thanhtung2105/Chika-CA-SWWx/Develop - Module CA-SWW/Schematic/87289124_199041944805929_6809010245046632448_n.png

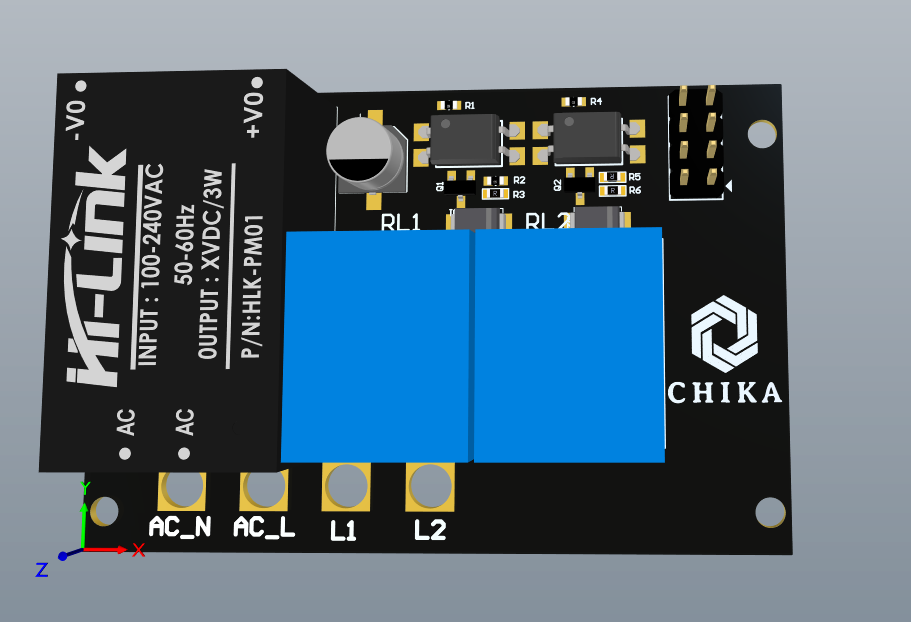
Develop - Module CA-SWW/Schematic/87289124_199041944805929_6809010245046632448_n.png
