thanhtung2105/Chika-CA-SWWx/Photos and Videos/89352153_235181460849834_5174523718583451648_n.jpg

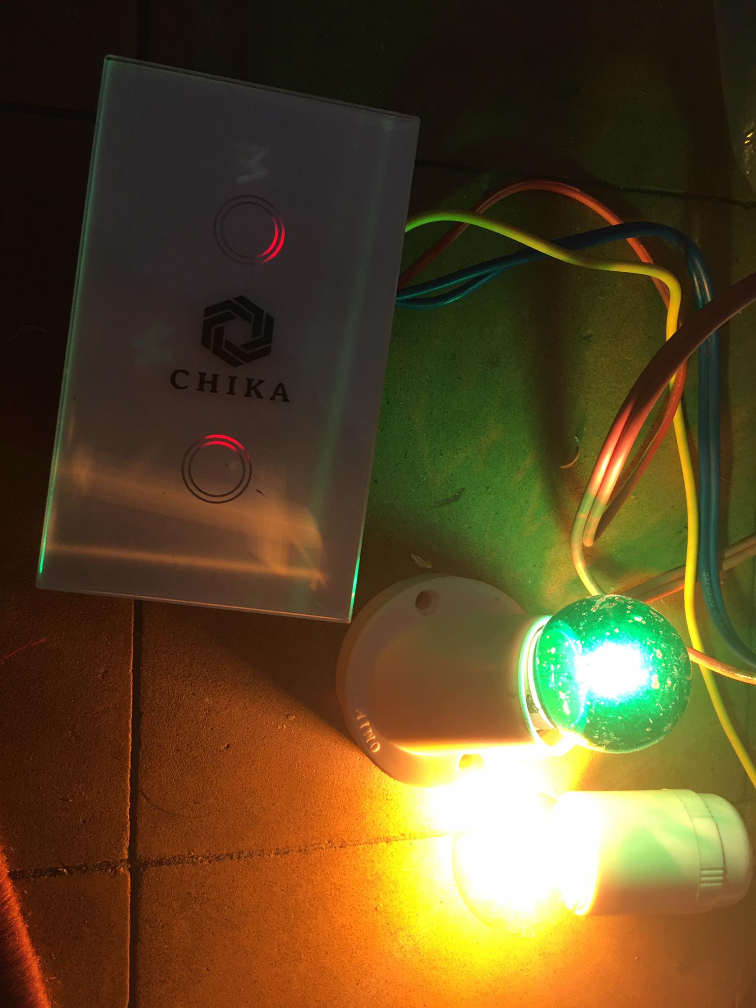
Photos and Videos/89352153_235181460849834_5174523718583451648_n.jpg
