thanhtung2105/Chika-CA-SWWx/README.md

# Chika-CA-SWWx

My Graduate Thesis project work co-operate with Chika Corporation 智家 (チカ).

📍 With 4 members (Thanh Tung, Sy Nguyen, Tai Phuc, Hoai Phuc), Chika Smart Home Joint Stock Company - 智 家 (チ カ) specializes in developing  solutions and devices for smart homes.

👉 Some product list:

- Infrared controller: CA - IRX.

- Touch switch: CA - SWW and CA - SWR

- Central control unit: CA - HC.

- Sensors system: CA - SS.

93224958_2582388615361445_2680312884105314304_o
System

⚙️ My first sample product - CA-SWW2 💎

# Schematic - Top side
touch_top-1
touch_top-2

# Schematic - Bottom side
touch-bot-1
touch-bot-2

87289124_199041944805929_6809010245046632448_n

86738742_577387229517883_3731519336825749504_n

86715783_187449332510564_7884290745375391744_n

off_off

on_on

on_off

    Author: Phan Thanh Tung
