thanhtung2105/Chika-CA-SWWx/Develop - Module CA-SWW/CA-SWW2/b36e333e-3800-4450-84cd-6f90e7e0f721/README.txt

{
    "id": "b36e333e-3800-4450-84cd-6f90e7e0f721",
    "name": "CA-SW2",
    "time": "05:35 23/12/2019",
    "userId": null,
    "devices": [
        {
            "id": "0c38a97d-1564-4707-935c-18b4e9bcb0db",
            "name": "",
            "state": 0,
            "roomId": "",
            "switchId": "b36e333e-3800-4450-84cd-6f90e7e0f721"
        },
        {
            "id": "7f704fdf-fa4b-44e2-b359-5ef19294196a",
            "name": "",
            "state": 0,
            "roomId": "",
            "switchId": "b36e333e-3800-4450-84cd-6f90e7e0f721"
        }
    ]
}
