thanhtung2105/Chika-CA-SWWx/Schematics/Schematics.pptx

CHIKA Relay +

S+

GND

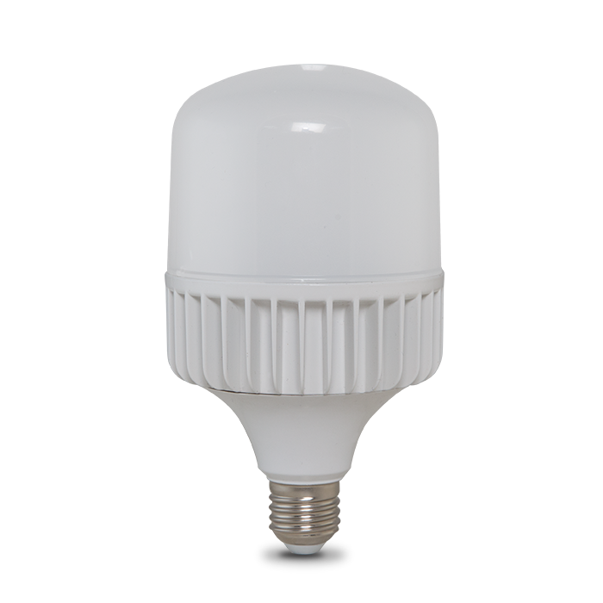
[picture p17: figure]
Image result for bóng đèn"

GND

S+

Pos

Neg

Pos

Neg

## Slide 2


## Slide 3

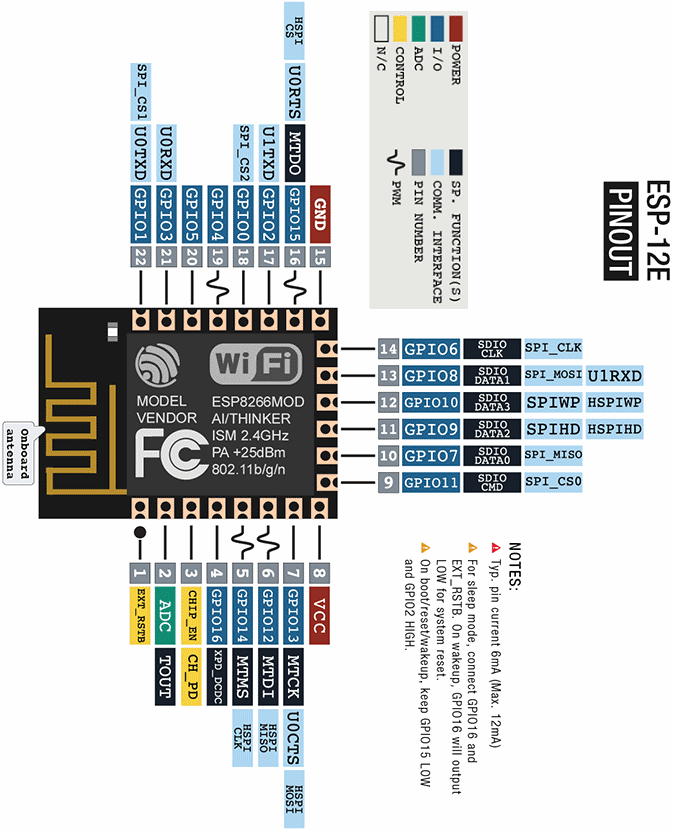
[picture p19: figure]
Ảnh có chứa ảnh chụp màn hình Mô tả được tạo tự động

## Slide 4

CA – SW2

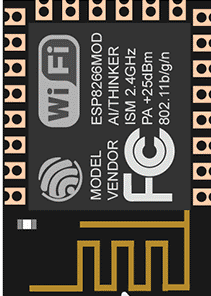
[picture p20: figure]
Ảnh có chứa ảnh chụp màn hình Mô tả được tạo tự động
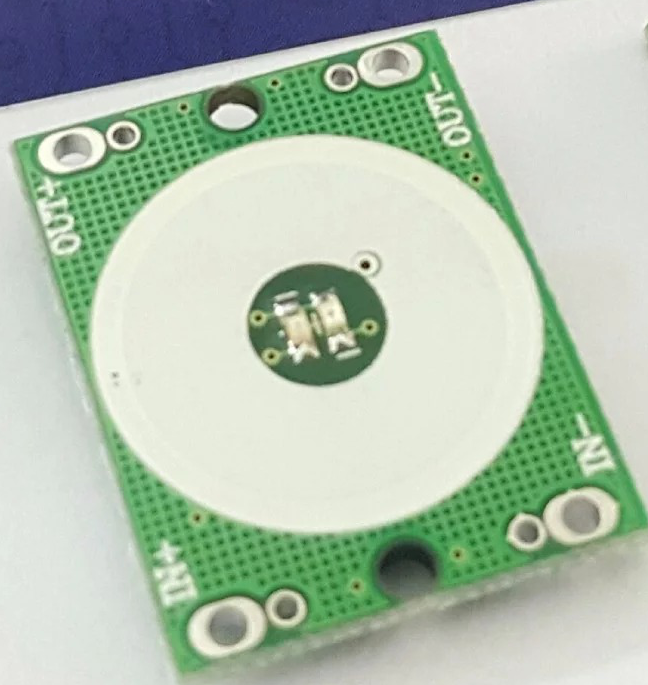
[picture p21: figure]

## Slide 5

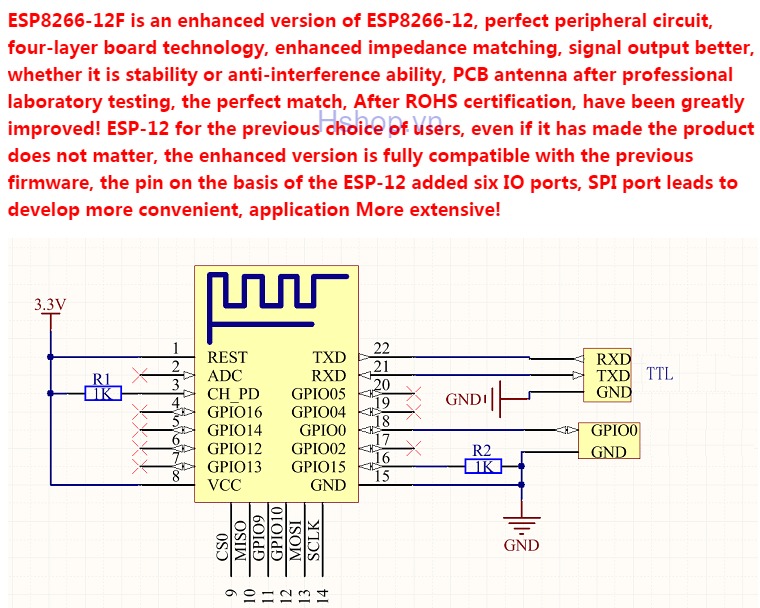
[picture p22: figure]

## Slide 6

CA-SW2

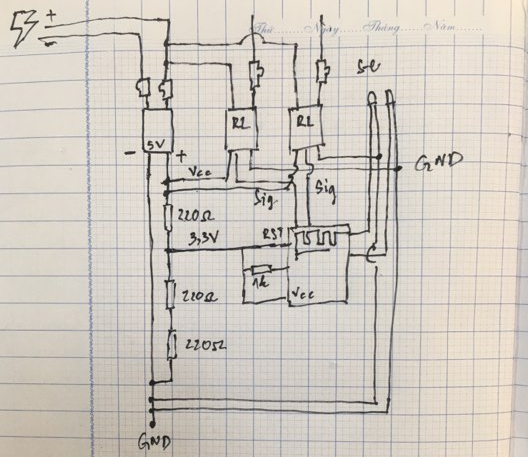
[picture p23: figure]

## Slide 7
