thanhtung2105/Chika-CA-SWWx/Develop - Module CA-SWW/Schematic/86715783_187449332510564_7884290745375391744_n.png

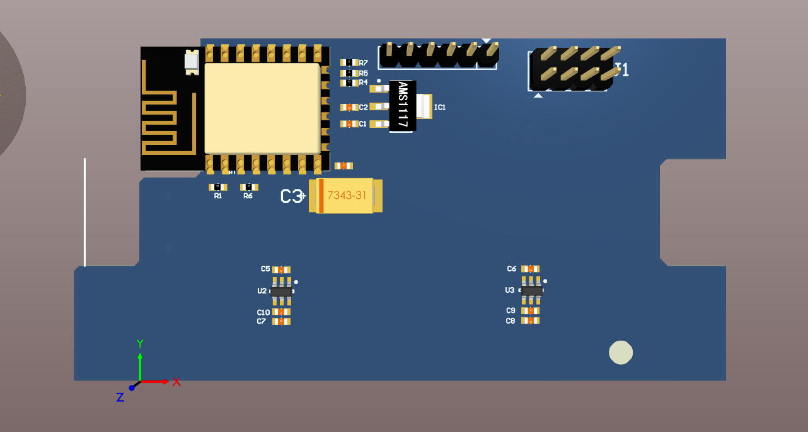
Develop - Module CA-SWW/Schematic/86715783_187449332510564_7884290745375391744_n.png
