thanhtung2105/Chika-CA-SWWx/Develop - Module CA-SWW/Schematic/86738742_577387229517883_3731519336825749504_n.png

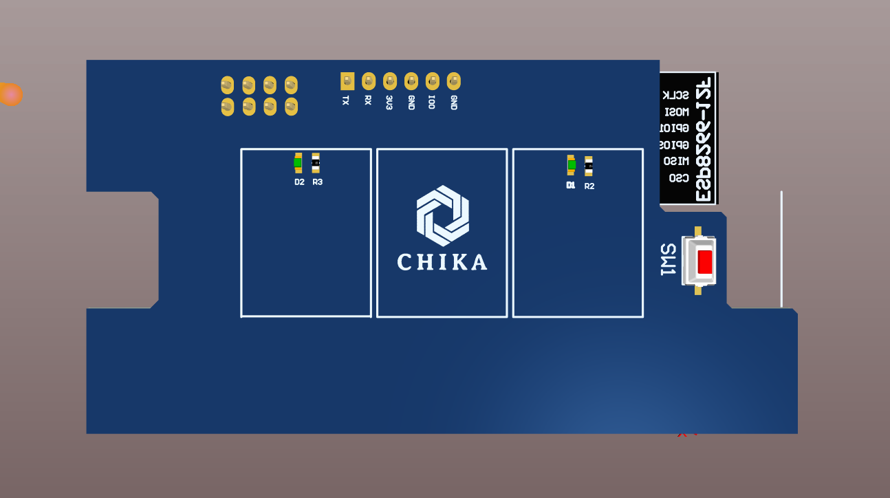
Develop - Module CA-SWW/Schematic/86738742_577387229517883_3731519336825749504_n.png
