thanhtung2105/Chika-CA-SWWx/Develop - Module CA-SWW/Schematic/touch-bot-2.jpg

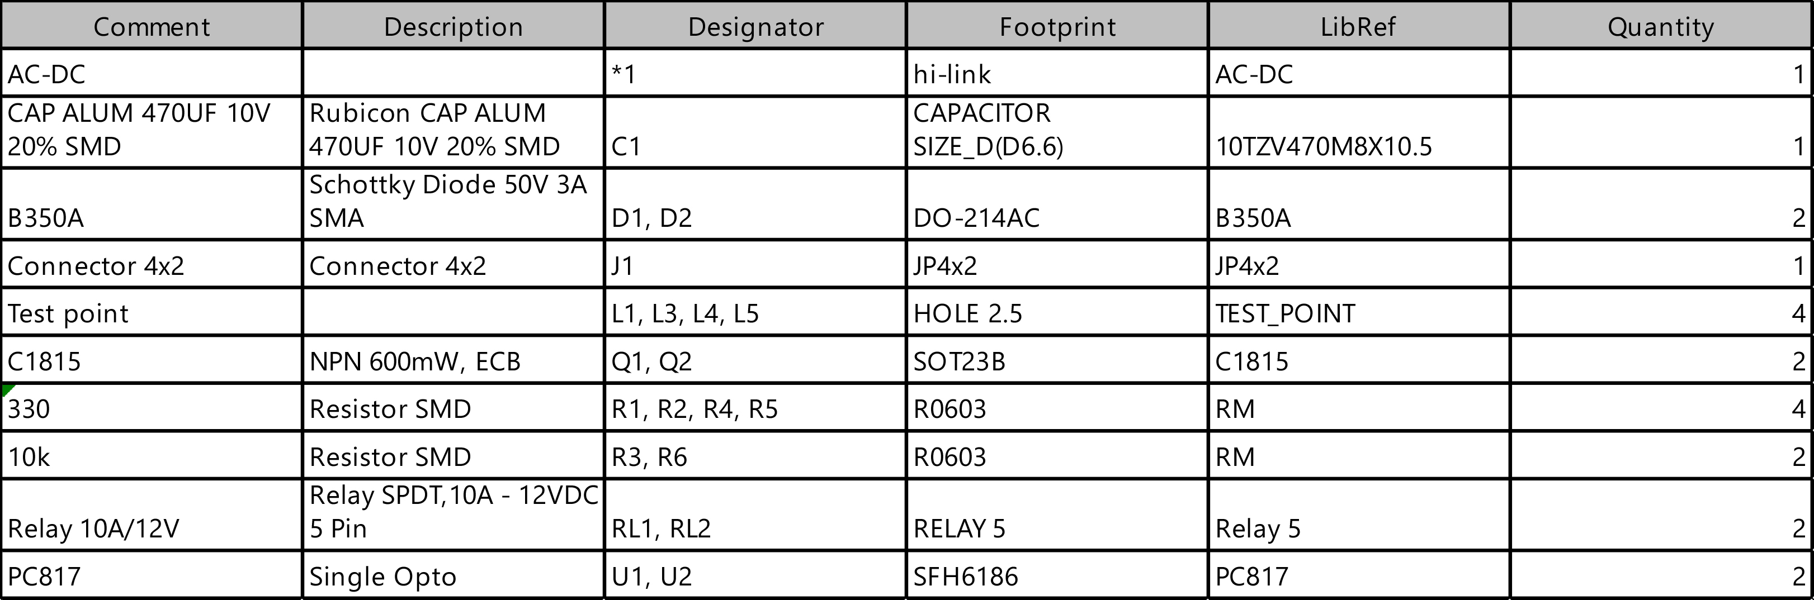
Develop - Module CA-SWW/Schematic/touch-bot-2.jpg
