thanhtung2105/Chika-CA-SWWx/Develop - Module CA-SWW/Schematic/touch_top-1.jpg

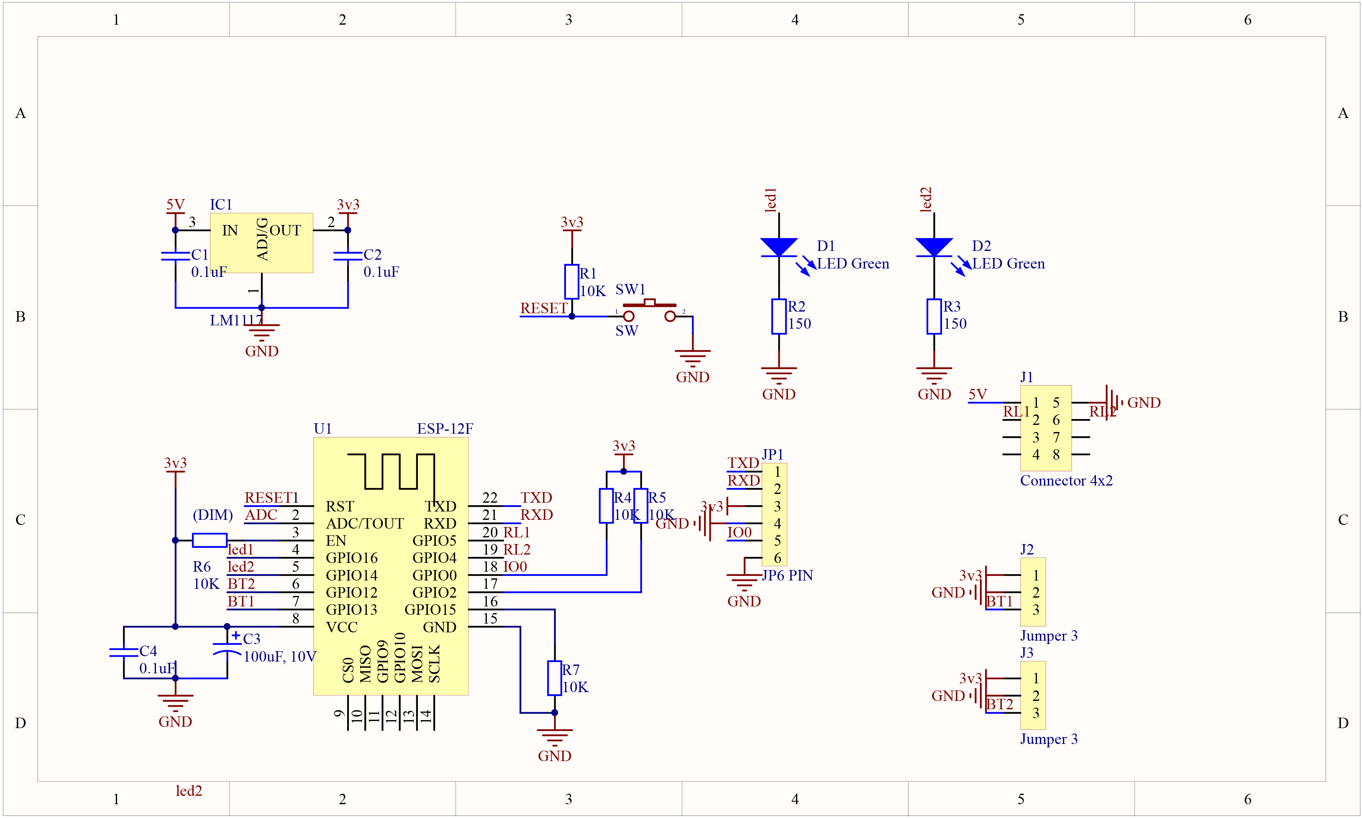
Develop - Module CA-SWW/Schematic/touch_top-1.jpg
