thanhtung2105/Chika-CA-SWWx/Develop - Module CA-SWW/Schematic/touch_top-2.jpg

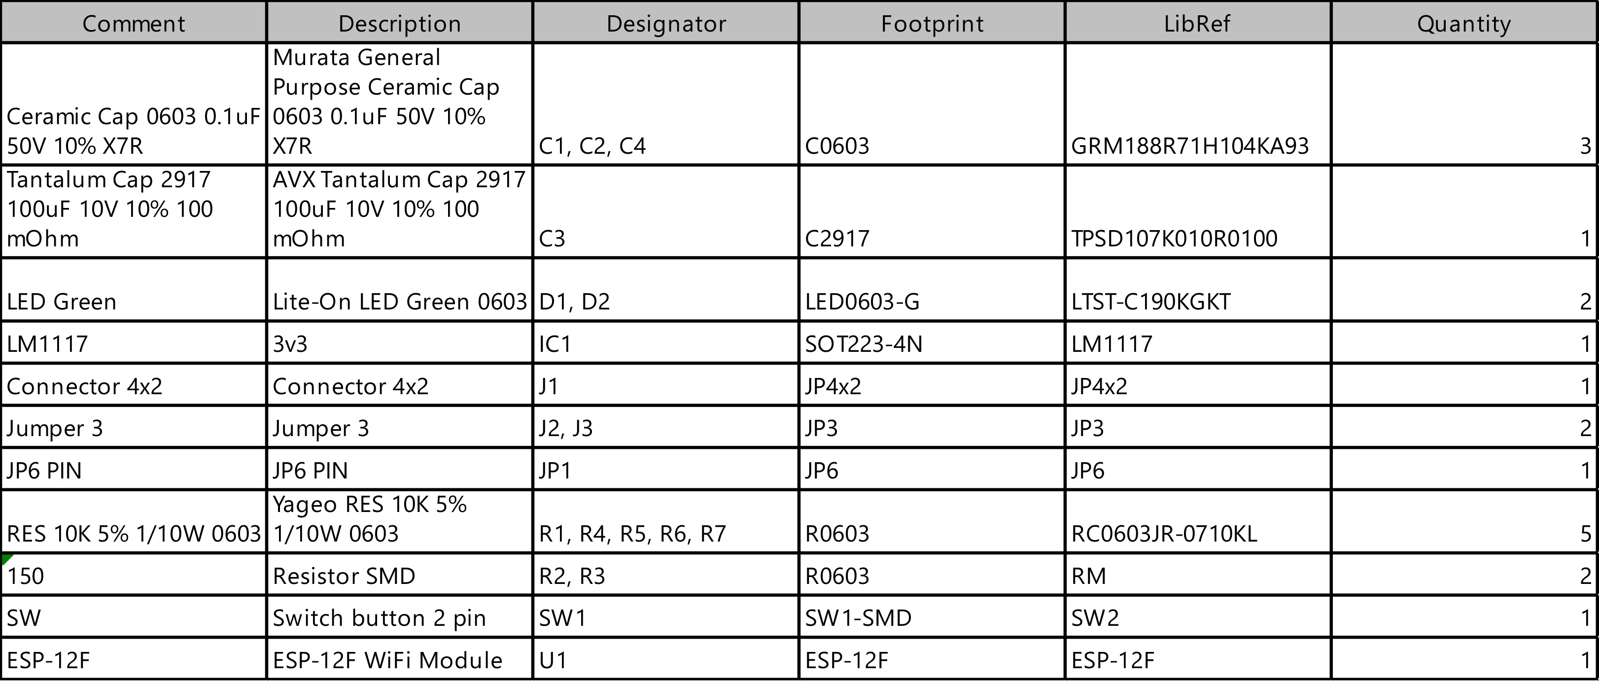
Develop - Module CA-SWW/Schematic/touch_top-2.jpg
