thanhtung2105/Chika-CA-SWWx/Photos and Videos/88984095_2592028717736543_9122740841440346112_n.jpg

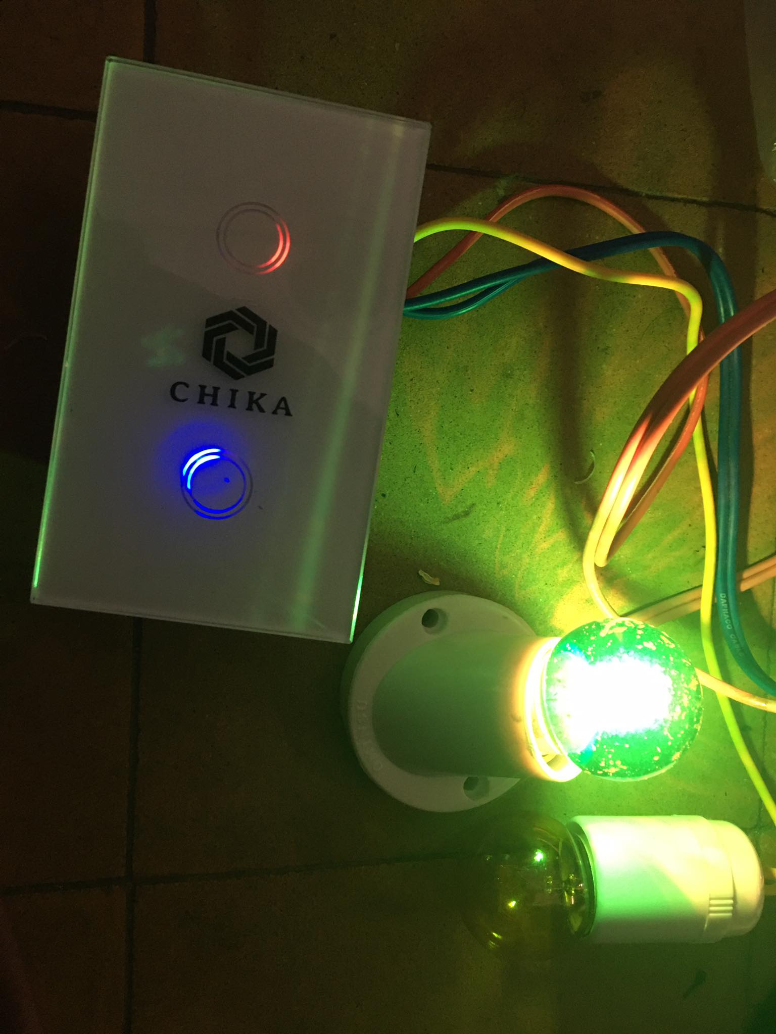
Photos and Videos/88984095_2592028717736543_9122740841440346112_n.jpg
