thanhtung2105/Chika-CA-SWWx/Photos and Videos/89547606_1107444239605126_4079126574987739136_n.jpg

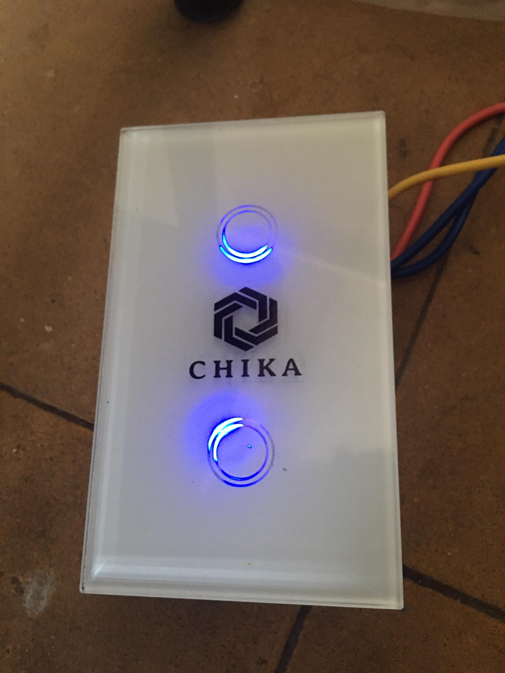
Photos and Videos/89547606_1107444239605126_4079126574987739136_n.jpg
