thanhtung2105/Chika-CA-SWWx/Photos and Videos/IMG_7603.JPG

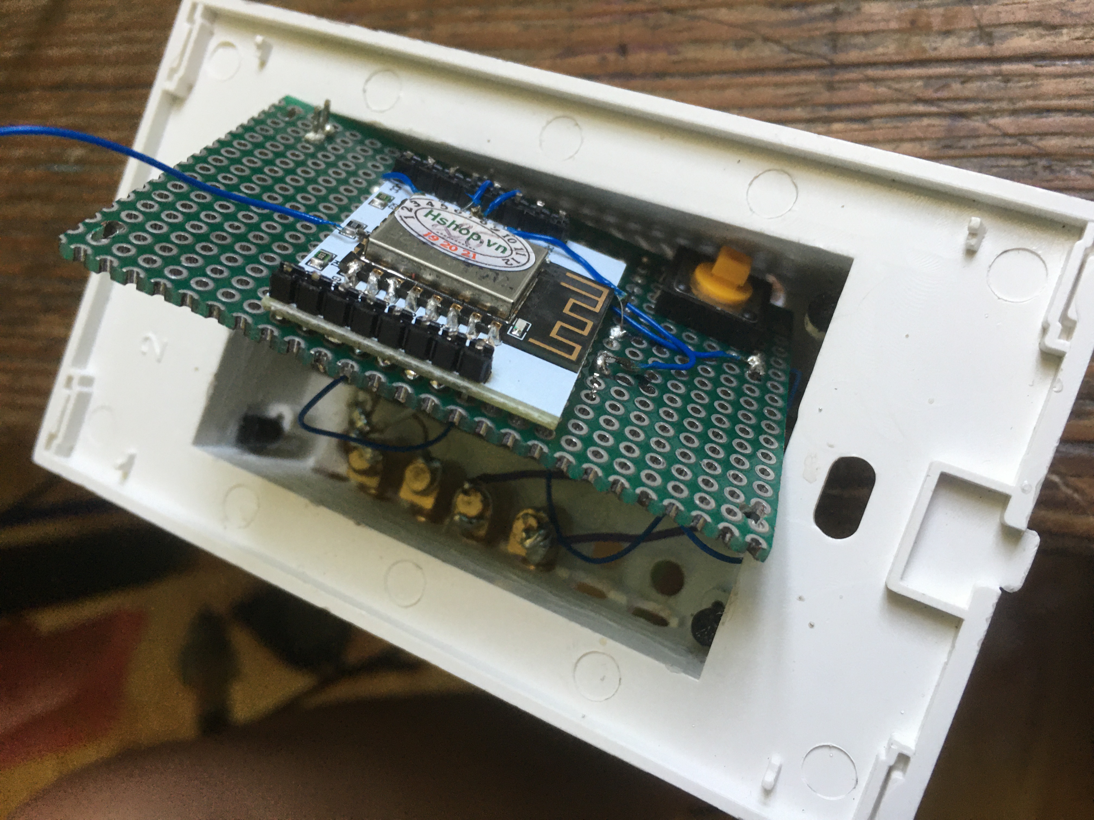
Photos and Videos/IMG_7603.JPG
