thanhtung2105/Chika-CA-SWWx/Photos and Videos/IMG_7617.JPG

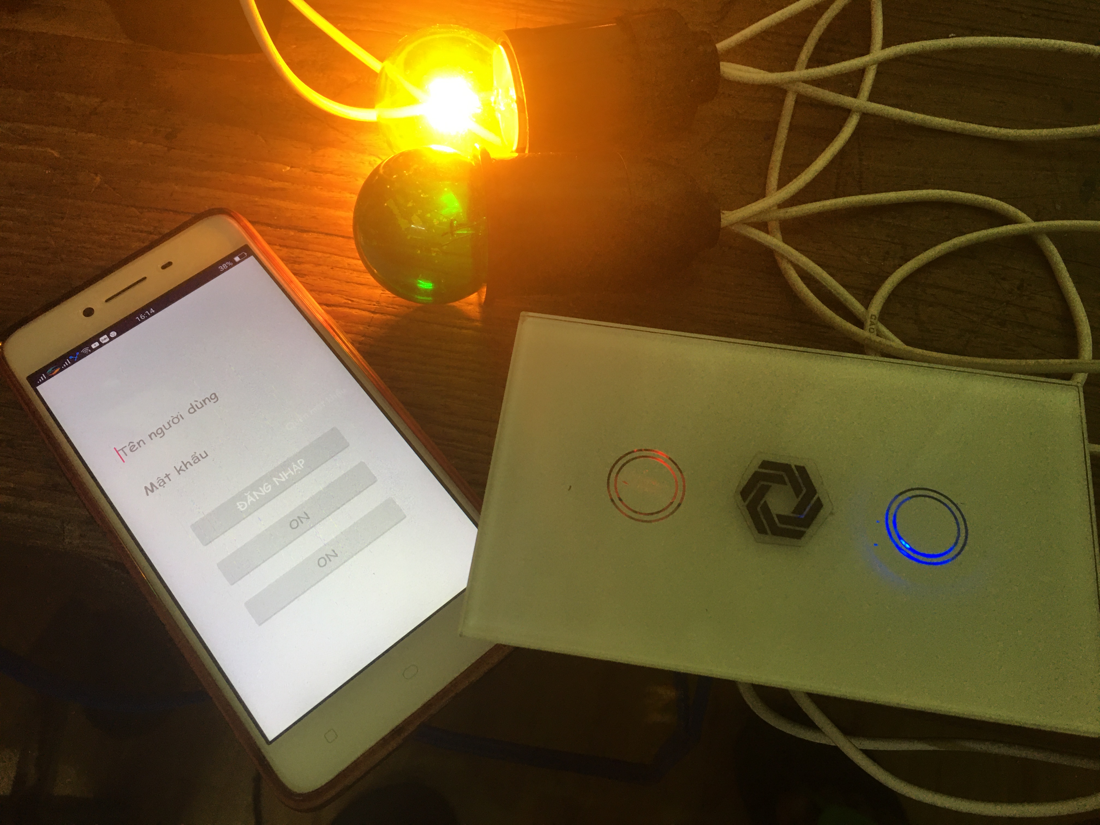
Photos and Videos/IMG_7617.JPG
