thanhtung2105/Chika-CA-SWWx/Photos and Videos/IMG_7618.JPG

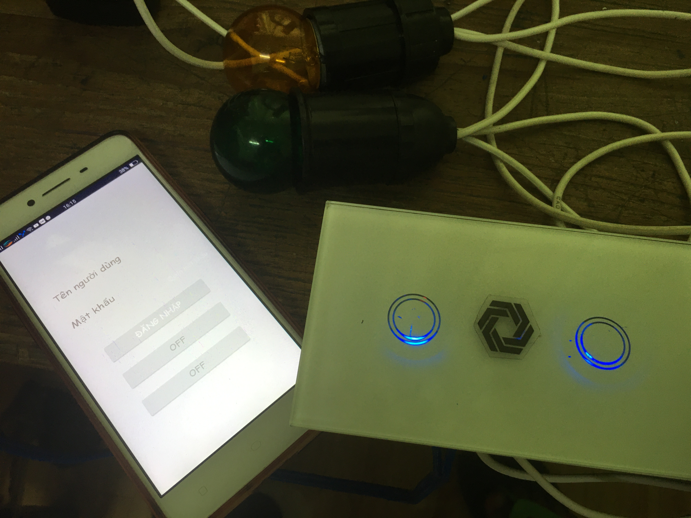
Photos and Videos/IMG_7618.JPG
