thanhtung2105/Chika-CA-SWWx/Photos and Videos/off_off.jpg

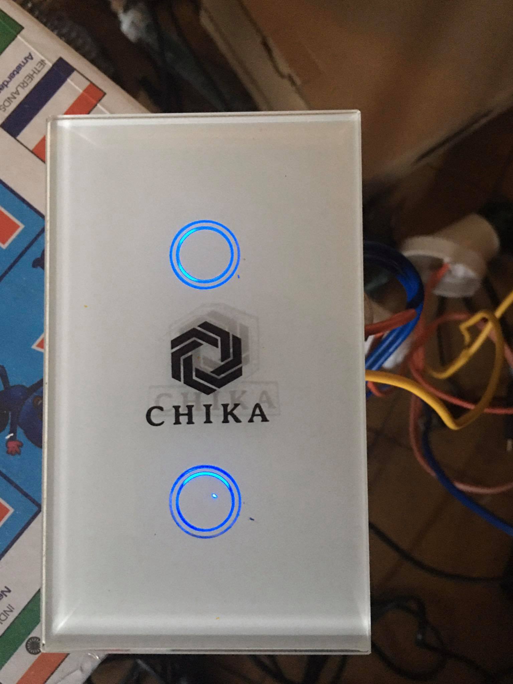
Photos and Videos/off_off.jpg
