thanhtung2105/Chika-CA-SWWx/Photos and Videos/on_off.jpg

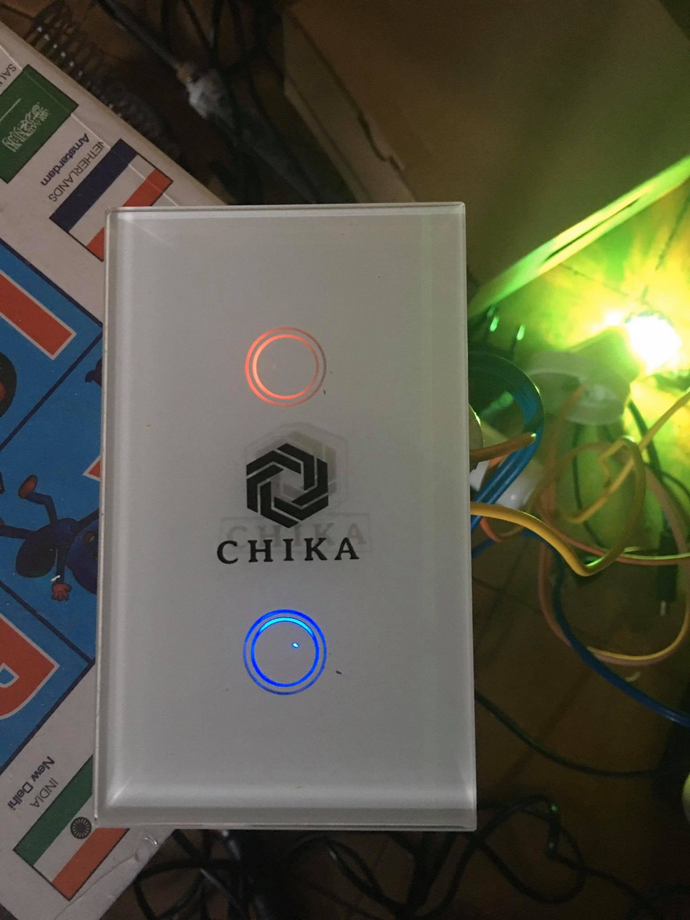
Photos and Videos/on_off.jpg
