thanhtung2105/Chika-CA-SWWx/Photos and Videos/on_on.jpg

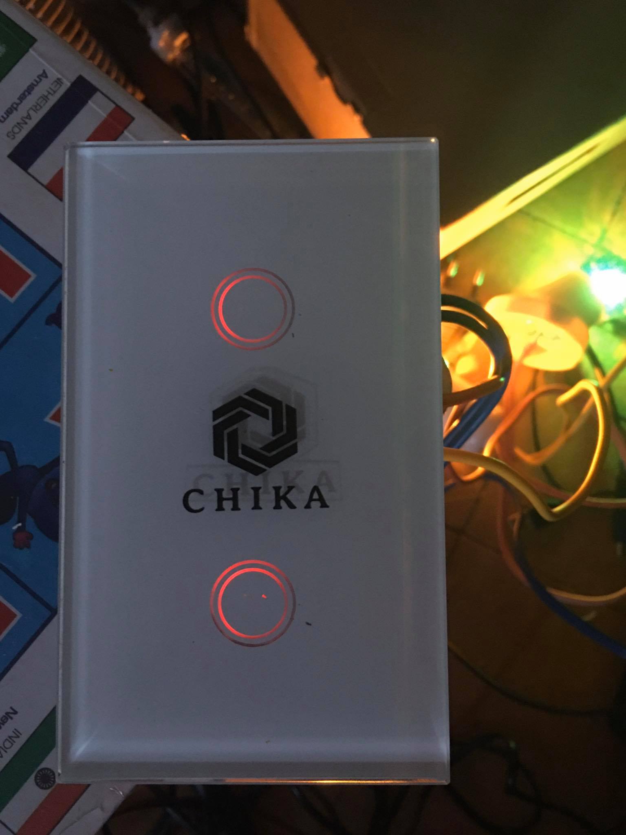
Photos and Videos/on_on.jpg
