thanhtung2105/Chika-CA-SWWx/Schematics/c1815-changif157106762_1571068579_1571668427.gif

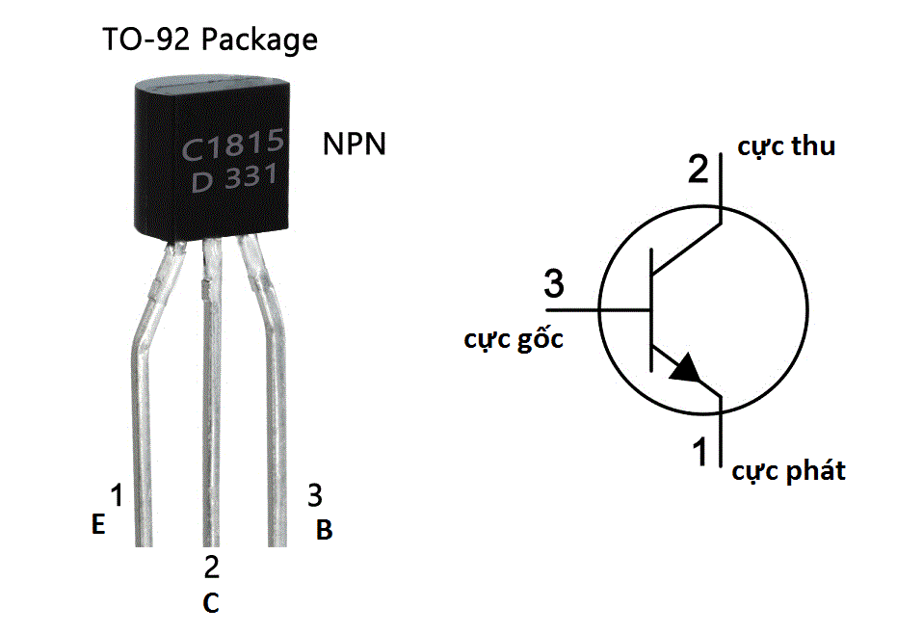
Schematics/c1815-changif157106762_1571068579_1571668427.gif
