thanhtung2105/Chika-CA-SWWx/Schematics/relay.jpg

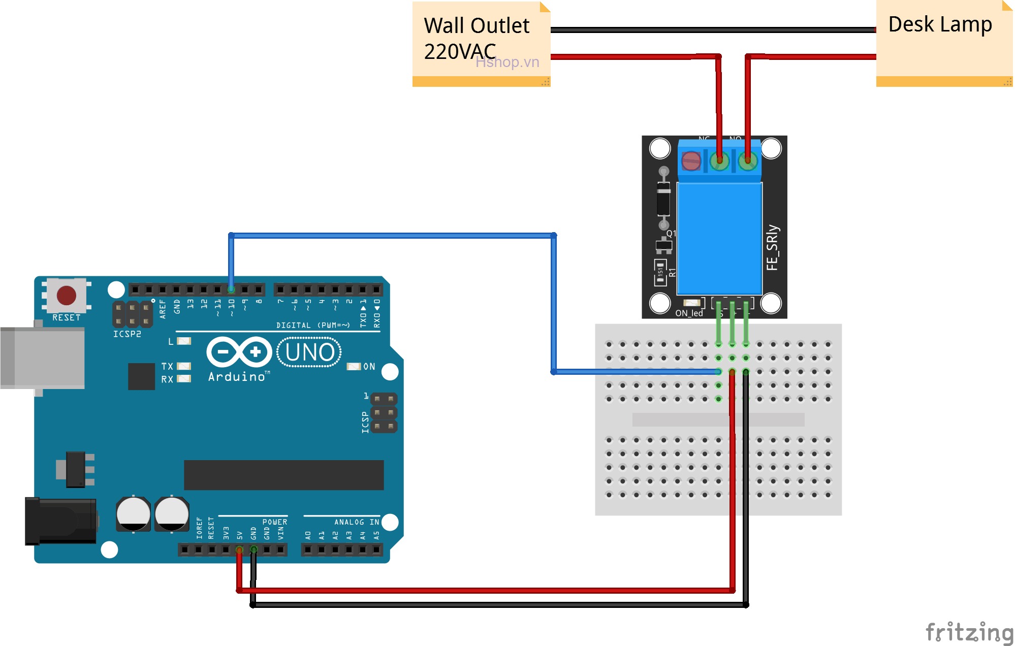
Schematics/relay.jpg
