thanhtung2105/Chika-CA-SWWx/Develop - Module CA-SWW/CA-SWW2_main/CA-SWW2/test/README

{
    "id": "6e2b871e-fd51-4006-af7b-a3ab59b17c40",
    "name": "CA-SW2",
    "time": "05:54 10/02/2020",
    "userId": null,
    "devices": [
        {
            "id": "6883dd85-c759-428c-98fe-77b00c20c710",
            "name": "",
            "state": 0,
            "roomId": "",
            "switchId": "6e2b871e-fd51-4006-af7b-a3ab59b17c40"
        },
        {
            "id": "7f669cb3-2189-4c22-ae09-cb6cc663b96d",
            "name": "",
            "state": 0,
            "roomId": "",
            "switchId": "6e2b871e-fd51-4006-af7b-a3ab59b17c40"
        }
    ]
}
