thanhtung2105/Chika-CA-SWWx/Develop - Module CA-SWW/Schematic/CA-SWWx_Schematics.PDF

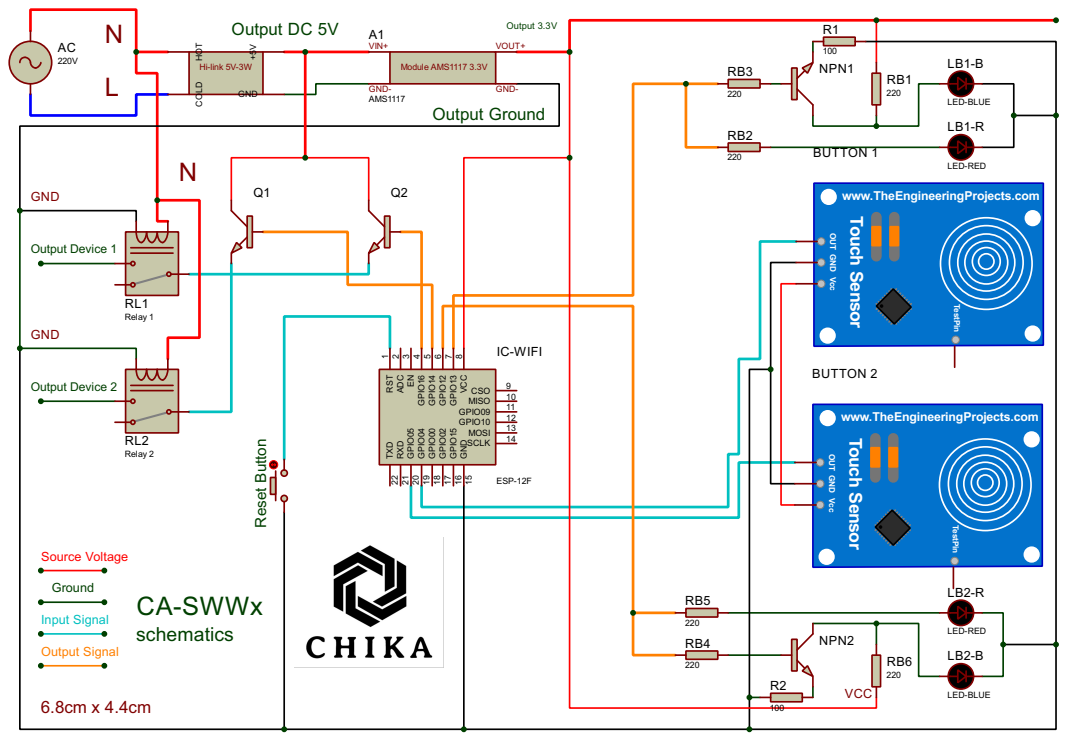
[picture p47: page 1]

RST 1 ADC 2 EN 3 GPIO16 4 GPIO14 5 GPIO12 6 GPIO13 7 VCC 8 CSO 9 MISO 10 GPIO09 11 GPIO10 12 MOSI 13 SCLK 14 GND 15 GPIO15 16 GPIO02 17 GPIO00 18 GPIO04 19 GPIO05 20 RXD 21 TXD 22 IC-WIFI ESP-12F RL1 Relay 1 RL2 Relay 2 www.TheEngineeringProjects.com Touch Sensor Vcc OUT GND TestPin BUTTON 2 NPN1 NPN2 LB1-B LED-BLUE LB2-B LED-BLUE LB1-R LED-RED LB2-R LED-RED www.TheEngineeringProjects.com Touch Sensor Vcc OUT GND TestPin BUTTON 1 AC220V NL Output DC 5V Output Ground Output 3.3V Reset Button N GND GND Output Device 1 Output Device 2 RB1 220 RB2 220 RB3 220 RB4 220 RB5 220 RB6 220 VCC Source Voltage Ground Input Signal Output Signal Q1 Q2 Hi-link 5V-3W +5V GND COLD HOT Module AMS1117 3.3V VIN+ GND- GND- VOUT+ A1 AMS1117 R1 100 R2 6.8cm x 4.4cm 100 CA-SWWx schematics
