thanhtung2105/Chika-CA-SWWx/(list of files, drawings)

Other design files:
Develop - Module CA-SWW/Schematic/CA-SW2.pdsprj
Develop - Module CA-SWW/Schematic/main.schdoc
