thanhtung2105/Chika-CA-SWWx/(commit log)

2020-01-21 Create [Nshopvn]Phần mềm nạp firmware và firmware AT.rar
2020-02-20 Create Arduino Pro Mini Library for Proteus.rar
